TinyTapeout/tt123-demo-pcb/(notices)

Notices in the files:
mpw-mb1.kicad_sch:
(C) 2023 Pat Deegan
